ArduinoSoilH2O/LoRa-Gateway-Node-Network/Core and Libraries List 2017.pdf

Core:

- LowPowerLab ‐ Moteino Core

Libraries:

- Adafruit – Adafruit_SHT31
- EnviroDIY – Arduino‐SDI‐12
- LowPowerLab ‐ LowPower
- PaulStroffregen ‐ OneWire
- PaulStroffregen ‐ RadioHead
- Adafruit ‐ RTClib
