ArduinoSoilH2O/LoRa-Gateway-Node-Network/CIG 2017 Soil Moisture Data Logging Network.pdf

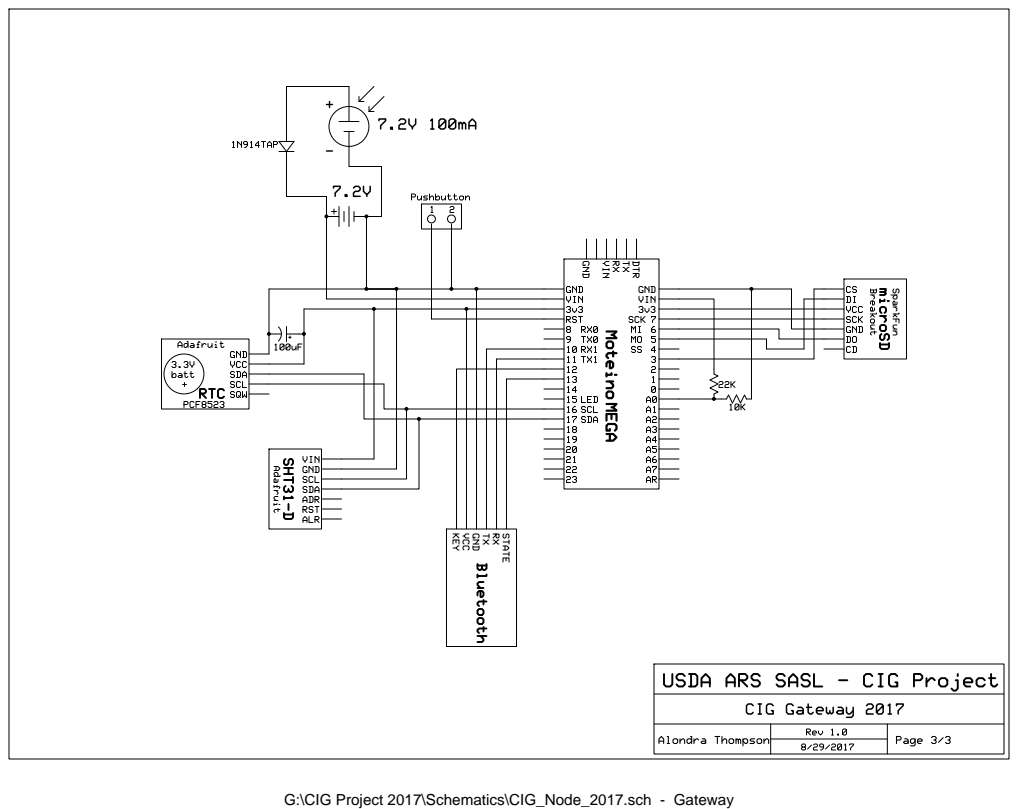
[picture p1: page 1]

G:\CIG Project 2017\Schematics\CIG_Node_2017.sch - Gateway

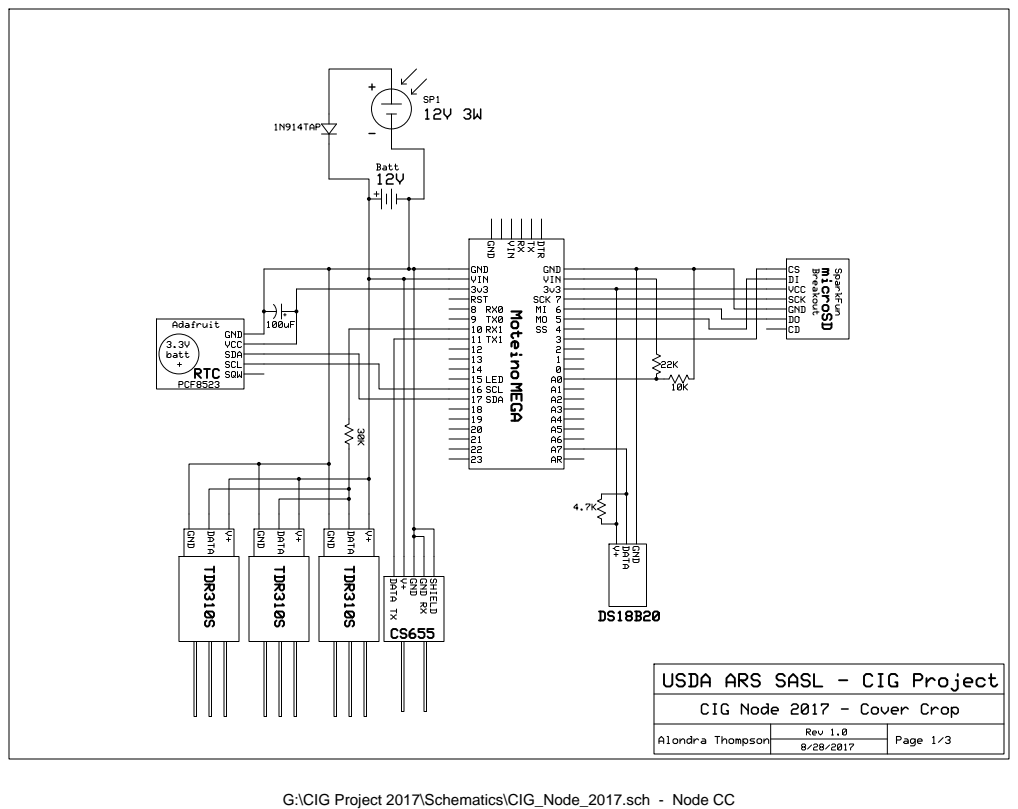
[picture p2: page 2]

G:\CIG Project 2017\Schematics\CIG_Node_2017.sch - Node CC

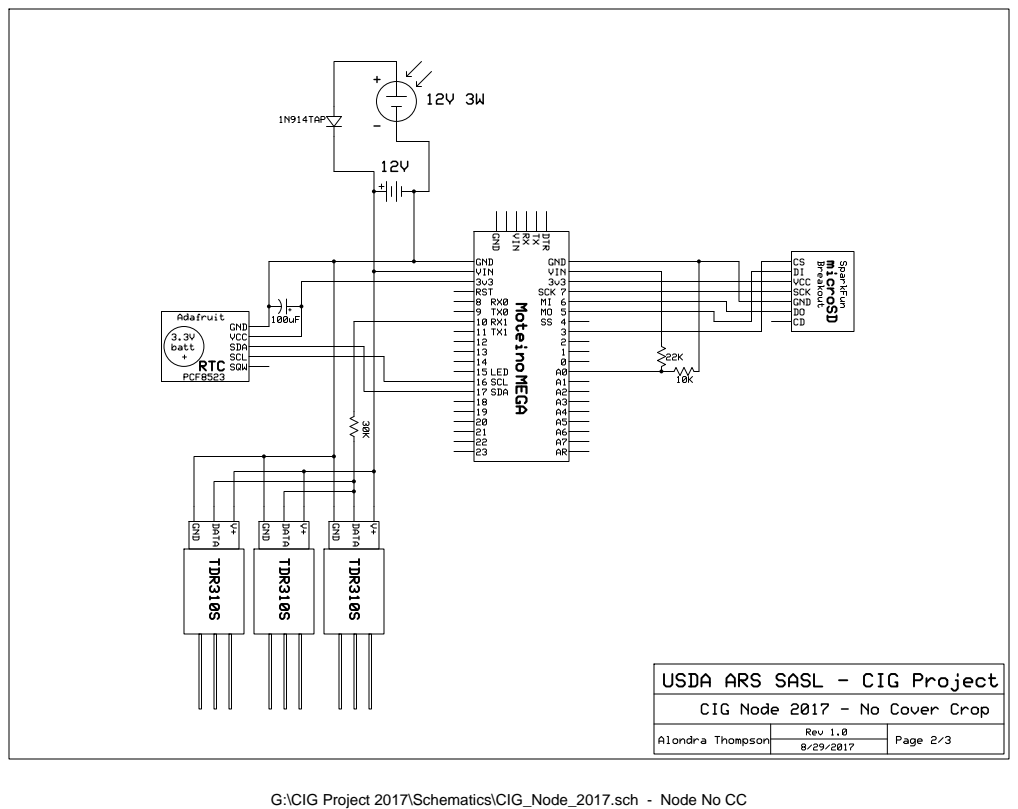
[picture p3: page 3]

G:\CIG Project 2017\Schematics\CIG_Node_2017.sch - Node No CC
